Carlos-0798/desk-buddy/hub/README-zh-CN.txt

Desk Buddy Hub 1.7.1 — R9 / 离线配置恢复

运行项目根目录 outputs/hub-r9/windows-final/DeskBuddy.Hub.exe；不需要更新设备固件。
这次修复的是 Hub 未连接启动时显示默认外观的问题，不是设备保存丢失。
首次使用新版先连接一次；以后关闭重开，未连接时显示上次设备回读的主题、角色和按键配置。
合法的未发送本地草稿也会自动保留；页首明确区分“本地草稿”“上次设备快照”“设备当前回读配置”。
第一次没有历史记录时显示“示例配置”，不把默认图当成设备当前状态。
重新连接只读取，设备回读优先。保留的草稿可按“载入保留的本地草稿”放回编辑器，再自行选择预览或保存。
载入草稿不会发送配置、开启输出或连接设备；明确按“读取设备”会用设备值替换并清除保留草稿。
本地快照不代表设备闪存保存成功，设备“预览/保存”原有 ACK/GET/STATUS 规则不变。
缓存位置：%LOCALAPPDATA%\DeskBuddy\Hub\workspace-v1.json，含独立快照/草稿、校验和及 .bak 恢复副本。
不缓存设备 ID、蓝牙配对、连接权限、实时状态或输出开关；不可用缓存会提示，保存失败可导出 JSON。
本轮不改变屏幕休息设置的独立设备保存，也不新增语言、缩放或连接自动恢复。
构建：hub/build.ps1 -Publish -OutputDirectory outputs/hub-r9/windows-final，拒绝覆盖非空目录。
软件证据见 outputs/hub-r9；测试只用隔离文件和模拟连接，不接触真实 AppData 或设备。
以下保留历史版本说明。
Desk Buddy Hub 1.7.0 — R8 / R3H 自定义休屏时间

运行项目根目录 outputs/hub-r8/windows-final/DeskBuddy.Hub.exe。
设备页“屏幕休息”支持 USB／电池各自选择：永不、30秒、1分钟、5分钟、20分钟、30分钟、1小时、自定义。
自定义填 1–720 的整数分钟，7分钟保存为420秒；无小数、负数、四舍五入或自动截断。
旧固件没有 display_custom 能力时保留原四档，长时间和自定义需升级设备固件。
连接只读取，不改变已有五分钟设置。未保存输入保留到同一连接内的切页或界面语言切换；轮询不覆盖文字、光标或选择。
读取当前会明确换回设备值；保存失败保留输入，等新鲜状态后可手动重试，不自动重发。
保存经 ACK/GET/STATUS 验证，与按键/外观草稿、224字节bank及输出开关独立，不发送隐藏OUTPUT1。
背光控制仍由 backlight_control 实时报出，休屏与整机关机不同。
构建：hub/build.ps1 -Publish -OutputDirectory outputs/hub-r8/windows-final；拒绝覆盖非空目录。
软件证据见 outputs/hub-r8，实板与物理验收由独立记录说明；本说明不把离线软件测试当作实物验收。
若需降级R3G，应先把两路时长恢复为永不、30秒、1分钟或5分钟，避免旧固件无法解码扩展时长记录。
以下为历史版本说明。

Desk Buddy Hub 1.6.0 — R7 / R3G 屏幕休息

当前构建入口：../outputs/hub-r7/windows-final/DeskBuddy.Hub.exe。
“设备”页新增独立屏幕休息卡：USB/电池各选永不、30秒、1分钟或5分钟；读取、保存、立即休屏、唤醒。
读取实时状态，保存经独立 DISPLAY SET/GET/STATUS 核对，不改变按键/外观草稿或224字节配置库。
初始固件未接 LITE 时只隐藏画面，背光仍亮；只有明确 backlight_control=1 才显示背光可控。
休屏不是整机关机，也未据此宣称续航提升。首次实体输入只唤醒，抬起后再操作；输出开关不自动开启。
HID 暂停包括屏幕休息、唤醒输入隔离和测试页；它不等于用户关闭输出。
动作选择增至40项：新增本地“立即休屏”，旧设备缺少sleep_binding能力时阻止发送，原映射保持兼容。
连接和轮询只读取，不自动保存默认超时、不重放本地草稿、不唤醒休屏。
当前软件证据与硬件验收分别记录在 outputs/hub-r7；本说明不把离线测试当作补线/背光实物验收。
默认构建目录已切换R7，仍拒绝覆盖非空目录；明确发布命令为 hub/build.ps1 -Publish -OutputDirectory outputs/hub-r7/windows-final。
协议见 PROTOCOL.md，Core API 见 DeskBuddy.Core/API.md。以下保留旧版历史说明，新差异以上述协议为准。

Desk Buddy Hub 1.5.1 — R6.1 / R3F 页面兼容候选（历史）

本轮新增 preserve_page_output 能力与 hid_suppressed 状态；输出开关开启和测试页暂停发送分别显示。
新能力设备的诊断/活动页保留开关，暂时暂停 HID；信息/管理/语言/工具页允许普通输入。
校准仍关闭输出；返回不自动发送开启命令。旧 R3E 没有新能力时保持旧页面规则。
构建默认输出 outputs/hub-r6-1，仍拒绝覆盖非空发布目录；旧 R6 文件不变。
本轮 managed Core 与 App 构建结果见 ../outputs/hub-r6-1/core 与 build 日志。
当前候选未因这些检查而宣称 GUI、实板或物理验收通过；等待根代理整合验证。
协议与 API 见 PROTOCOL.md / DeskBuddy.Core/API.md。

以下为 R6 已验证基线与 R5 历史说明；R3F 差异以上述及能力协商文档为准。

Desk Buddy Hub 1.5.0 — Windows 伴生控制软件（R6 / 固件 R3E）

当前版本：2026-10-05 R6
运行 ../outputs/hub-r6/windows/DeskBuddy.Hub.exe。
使用说明及手动观察步骤：../outputs/hub-r6/START-HERE-zh-CN.txt。
修复外观/动作/配置操作不必要关闭输出；按键、旋钮、触摸联动角色；统一圆角下拉框，保留键盘语义与滚动。
476项WPF检查、1965项Core断言、182项USB/BLE实板协议检查通过；正式EXE的USB窗口连接、输出ON下预览/保存/开心、再OFF与复读通过。实屏动画观感和此版本纯电池尚待用户观察。
build.ps1 发布默认目录更新为 outputs/hub-r6，非空目录仍拒绝覆盖；旧R5交付保留。
完整证据、限制、哈希见 ../outputs/hub-r6/release-status.json。

以下为 R5 历史说明；与上述 R6 行为冲突时以上述和 PROTOCOL.md 的能力协商规则为准。

当前验收状态（2026-10-05）
R5 正式电脑端的普通启动、离线渲染、Core 检查及正式 EXE 的 USB 实板 smoke 均已通过。
R3D4 实板自动检查通过：USB 静默、10 次 BLE 加密重连、28 项 BLE 检查，以及两轮各 32 项保存与软件重启检查。
保存检查包含 CCCD 退订后立即请求软件重启；原保存配置、触摸校准、语言和 BLE 配对已恢复并完成保持性复验。
正式 GUI 的 BLE 连接、状态更新和走路试播回读已通过；后续 GUI 还原、撤权提示、断开与重连尚未完成，不能称完整 GUI 验收通过。
R3D4 保留 R3D3 的受控软件重启存储屏障：排在既有后台保存之后执行，取得 FS 锁、刷新缓存并保持锁直至复位。
R3D4 另在等待重启或重启失败时继续重试原连接的 HID 零报告释放，不发送新按下报告、不重新挂接 USB 或重启蓝牙广播。
R3D4 目标构建及静态检查已通过；新增 C++ 测试仅编译，runtime 断言执行数为 0，不替代异常释放路径的实物验证或整机验收。
这不等于已解决物理断电、实体 Reset 或 DFU 中断写页的所有风险；物理冷启动与电池独立运行仍须另行验收。
最终 EXE 哈希、检查数量和最新结论见 ../outputs/hub-r5/release-status.json
及 ../outputs/hub-r5/TEST-REPORT-zh-CN.txt；不要用历史版本记录代替最终复验。

下一步：可以开始五项人工验收
1. 电池独立供电下的 BLE 管理。
2. 实屏动作与触摸。
3. BLE 管理与真实 HID 输入并用。
4. Windows 睡眠后恢复。
5. 正常保存后的完全断电与设置保持。
具体操作与停止条件见 ../outputs/hub-r5/MANUAL-CHECKLIST-zh-CN.txt。
五项均未因自动检查通过而视为完成；软件 REBOOT 不能代替同时断开 USB 与电池后的物理冷启动。

定位
本软件管理 Desk Buddy 原型机，可选择 USB CDC 串口或已配对设备的 BLE GATT 管理连接。
R5 支持通过 BLE 读取状态、编辑/预览/保存三套配置与按键/外观、动作试播及还原。
管理连接与 USB/BLE 媒体键/键盘 HID 输出是两个独立选择，连接 Hub 不会自动开启 HID。
电池供电时，已建立的 BLE 管理连接可以在拔掉 USB 后继续使用；仅 USB 管理会随拔线断开。
本软件不需要账号、云服务、管理员权限或开机自启。

启动
1. 解压完整 Windows 发布包到普通本地文件夹。
2. 双击 DeskBuddy.Hub.exe。首次启动不会自动开启设备输出。
3. 管理连接选择“USB 线缆”，重新检测并选择 Desk Buddy 的 COM 端口后连接。
4. 如果出现端口占用，关闭 Arduino 串口监视器或其它测试程序，再重试。
5. 若看到旧版 R2C，基本状态仍可读；配置编辑需要 R3，新增主题/角色/主页模式需要 R3A。
   Hub 不自动刷写固件。不要用其它型号的固件或擦除校准/配对数据。
用户已确认本机双击能打开 Hub；签名暂不处理，不影响正常本地开发与交付。
R3D4 自动检查已通过；人工五项及尚未完成的 GUI 还原/撤权提示/断开重连仍需验证，进度以本轮测试报告为准。

BLE 管理连接
1. 先确认 Desk Buddy 已在 Windows 蓝牙设置中配对；已有配对无需删除重建。
2. 在小屏“菜单 → 设备信息 → 蓝牙管理 → 允许蓝牙连接”打开最长 60 秒连接窗口；
   或在 USB 管理中点“通过 USB 允许 BLE”。这一步会关闭 HID 输出。
3. 断开当前 USB 管理（可保留 USB 供电），管理连接选“蓝牙 LE · 已配对设备”，
   重新检测、选择自己的 Desk Buddy，再连接。成功后显示 BLE GATT 管理。
4. 连接采用加密链路、已绑定设备与设备端管理授权；配对本身不等于管理授权。
5. 开始管理后连续 15 秒没有成功请求会撤权。正常 Hub 轮询保持会话；
   断开、睡眠或异常后重新在设备端授权，再手动重连，不重放旧操作。
这些是 R5 的使用流程；最终硬件能否正常执行仍以本轮发布状态和测试报告为准。

页面
设备：管理连接、USB/BLE HID 通道、输出开关、电量估算、当前配置和输入状态。
控制配置：K1–K6、顺转、逆转、旋钮按压、三个触屏键，共 12 个映射。
外观：八种主题、十二个角色、三种主页模式、待机动画开关、强调色及软件预览。
诊断：输入计数、固件与连接信息、有限长度的日志和导出。

配置的三个阶段
编辑只改变电脑上的草稿。
预览把草稿应用到设备内存，不写入 Flash；设备输出会关闭。
保存才把完整配置写入设备，并读取确认；设备输出也会关闭。
预览/保存会提交全部三套配置，并把当前正在编辑的页签设为设备活动配置。
还原恢复设备最后保存的配置。未保存预览在设备断电/重启后丢失。
发生版本冲突时先重新读取设备；Hub 不会在重连时偷偷覆盖设备。
MEDIA / STUDY / WORK 是三套独立保存的配置，不是会自动识别应用的智能模式。
出厂按键映射完全相同；切换名称本身不会自动改变用途。
MEDIA：建议配置播放、切歌、音量；STUDY：建议配置学习常用快捷键；WORK：建议配置工作软件快捷键。
这些只是使用建议，快捷键须由你在“控制配置”页设置；每套外观也可以不同。
它们与“表情面板 / 桌面伙伴 / 电子宠物”这三个显示模式是两回事。
当前配置名称使用 1–15 个 ASCII 字符；Hub 和屏幕界面可以使用中文或英文。
中文界面不受此限制；板载配置名称本身暂不支持中文。
导入/导出的是整个三配置集合；不包含触摸校准、蓝牙配对信息或任何执行脚本。

新增外观与桌宠
表情面板：全部十二个角色使用专用大头像，显示待机、眨眼和开心表情。
桌面伙伴：在设备小屏显示完整身体、脚/尾巴和待机动作。
电子宠物：显示完整伙伴与本次开机互动次数，并对本机操作短暂作出反应。
三种模式都保留连接状态、电量、菜单与三个触屏控制按钮。
主题、角色和模式可以独立组合，共 288 种；各套 MEDIA / STUDY / WORK 可以不同。
新的海洋、落日、花园、蓝图主题带有各自背景细节；兔子、幽灵、团子、太空伙伴、
狐狸、熊猫等采用有明暗、服饰和轮廓细节的原创像素游戏角色素材。
完整角色含待机、眨眼、开心、两帧迈步；幽灵以尾部摆动对应迈步。
旋钮格数触发短暂迈步，按钮/旋钮按下或有效触摸触发开心反馈。
互动统计来自按钮稳定按下、旋钮格数/按下、校准以外的有效触摸；松开不重复计数，
Hub命令不算互动。次数跨配置保留，但重启或重置计数后归零，不写入Flash。
R3B中，轻点主页中央角色区域会回应开心和爱心，不发送媒体键或其它HID。
30秒无有效实物输入后闭眼显示Zzz；下一次输入唤醒，原有绑定仍照常执行。
打盹只是视觉状态，不是MCU省电，也不自动关闭输出。
关闭动画会停止眨眼/迈步/爱心浮动循环，仍保留静态开心、爱心、打盹和互动计数。
R5外观页的“动作预览”把动作作为连续6秒演示：待机、眨眼、开心、走路、打招呼、休息、醒来。
不再让用户选择单独的“走路A / B”帧。全身模式自动交替两帧并轻微移动，头像模式不提供走路。
动作区旁边直接显示动画。未连接设备时只在电脑预览；连接支持该功能的R3C后可同步小屏。
同步试播会先把当前草稿临时应用到设备，并关闭输出，再播放动作；不会保存到Flash。
“预览到设备”也会播放当前选择的动作。满意后再保存配置；动作演示本身不保存。
点击“停止预览”或等待6秒会回到真实设备状态，不会自动重新开启输出。
明确点击动作时临时播放动画，即使“日常动画”关闭；不会改变该开关的保存值。
设备的按键/旋钮/有效触摸会结束试播；原有绑定仍按当时输出状态执行。
演示不是物理输入，不增加设备真实互动计数，不发送媒体键。
设备30秒无输入时的打盹仍是正常行为；临时“唤醒”演示结束后可能回到打盹。
设备声明 BLE 管理和动作试播能力后，USB 或 BLE 管理均可向小屏试播；仅 HID 配对不具备此管理能力。
本轮桌宠在设备屏幕上，不是 Windows 桌面悬浮窗；没有喂养、经验值或成长存档。
Hub与设备共用64×60全身角色、48×30专用头像及RGB565色板；Hub外框/文字仍是软件预览。
实际完整固件渲染图见配套 preview/index.html，不能当作实物显示照片。

旧固件兼容
旧 R3 的 HELLO 没有新能力字段，Hub按4主题、4角色、仅表情面板处理。
离线可编辑所有新外观，连接旧固件时不支持的配置会在发送前被拒绝；不会偷偷改回旧ID。
所有三套配置都会检查，不能只确保当前显示的一套兼容。
R3A支持相同288种配置，但新头像、轻触和打盹需要R3B。
R3C通过HELLO明确声明animation_preview能力，才允许新的远程动作试播。
BLE管理要求设备明确声明ble_management能力及专用GATT服务；旧R3C及更早固件仍使用USB管理。
旧R3B仍可编辑兼容配置，但动作仅电脑预览；Hub会明确提示，不会假装小屏已播放。
预览不会自动升级固件。
升级 R3B 后旧配置ID保持原样，表情模式换成新头像；若以后降级到 R3，须先保存旧版兼容的三套配置，
例如导入 01-original-face.json 再保存，以免旧固件拒绝新样式/模式。

按键能力
支持播放暂停、上一曲、下一曲、静音、音量加减；
支持一个标准键盘键加 Ctrl/Shift/Alt/GUI 修饰键的一次按下/松开；
左/右修饰键独立保留；GUI 在 Windows 上对应 Win 键。
支持打开菜单、记录标记、关闭输出、切换下一配置等设备本地动作。
不包含多步宏、长按保持或任意运行电脑程序的能力。
触屏按键的标签随映射调整，不应把已重映射的按钮当作原有媒体键。
主板 USER SW 长按约两秒关闭输出，独立于自定义映射。

连接和恢复
USB/BLE 管理连接负责 Hub 读写设置；USB/BLE HID 通道负责设备操作电脑，分别选择。
切换通道或修改配置后，请确认映射再主动开启输出。
关闭 Hub 不等于停止设备独立工作；要停止操作电脑，先关闭设备输出。
Windows 休眠、拔线或端口异常后，界面必须先恢复新鲜状态再允许操作。
不要同时运行两个 Hub 实例争用同一串口。
BLE 正常断开会请求并核对管理撤权，不改变原 HID 输出状态；退出 Hub 不等于关闭媒体输出。
若撤权/退订未获确认，软件会报告失败；在设备端撤销或停止管理请求并等待空闲超时。
另一管理端正在修改设备时可能返回 BUSY；不要反复发送写入。配置版本冲突返回 STALE，先重新读回。
显示未知或过期状态时，先检查连接，不应将旧数字当作当前测量。

电池显示的边界
百分比是根据电压作出的粗略估计，不是电量计芯片测得的真实剩余容量。
USB 供电状态不能证明正在充电，Hub 也不能测量电池温度、充电电流或实际续航。

本版不含
前台应用自动配置切换、云同步、任意图片/GIF皮肤上传、手机 App、无线固件升级或自动固件升级。
这些限制不影响设备离线执行已保存的媒体键/热键配置。

开发
源代码：DeskBuddy.Core（协议/配置/文件/有界BLE分片），DeskBuddy.App（WPF/USB串口/Windows BLE GATT/界面）。
协议定义见 PROTOCOL.md；固件位于 ../firmware/DeskController。
Windows x64 + .NET 10 SDK 可构建；发布包自带运行时，最终用户无需单独安装 SDK。
Core.Tests 为主机测试，不冒充实物按压、显示外观或电池断电验收。
具体本轮自动测试结果和待人工项目见发布目录 TEST-REPORT 与 MANUAL-CHECKLIST。
项目根目录执行 hub/build.ps1 -Publish，默认输出 outputs/hub-r5/windows；不自动启动应用。
可选签名工具独立于本地发布，说明在 outputs/hub-r5/signing；当前没有宣称可信签名发布。

调试与本地演示
在已打开的命令行中运行 DeskBuddy.Hub.exe --demo 可进入明确标注的演示模式，
它不访问实物串口或蓝牙。正常使用请直接双击 EXE，不加 --demo。
--render-smoke <输出目录> 只做离线测试；--device-smoke 会访问实物，仅供测试使用。
