Carlos-0798/desk-buddy/hub/DeskBuddy.App/README-zh-CN.txt

Desk Buddy Hub 1.7.1 — R9 / 离线配置恢复

运行项目根目录 outputs/hub-r9/windows-final/DeskBuddy.Hub.exe；不需要更新设备固件。
这次修复的是 Hub 未连接启动时显示默认外观的问题，不是设备保存丢失。
首次使用新版先连接一次；以后关闭重开，未连接时显示上次设备回读的主题、角色和按键配置。
合法的未发送本地草稿也会自动保留；页首明确区分“本地草稿”“上次设备快照”“设备当前回读配置”。
第一次没有历史记录时显示“示例配置”，不把默认图当成设备当前状态。
重新连接只读取，设备回读优先。保留的草稿可按“载入保留的本地草稿”放回编辑器，再自行选择预览或保存。
载入草稿不会发送配置、开启输出或连接设备；明确按“读取设备”会用设备值替换并清除保留草稿。
本地快照不代表设备闪存保存成功，设备“预览/保存”原有 ACK/GET/STATUS 规则不变。
缓存位置：%LOCALAPPDATA%\DeskBuddy\Hub\workspace-v1.json，含独立快照/草稿、校验和及 .bak 恢复副本。
不缓存设备 ID、蓝牙配对、连接权限、实时状态或输出开关；不可用缓存会提示，保存失败可导出 JSON。
本轮不改变屏幕休息设置的独立设备保存，也不新增语言、缩放或连接自动恢复。
构建：hub/build.ps1 -Publish -OutputDirectory outputs/hub-r9/windows-final，拒绝覆盖非空目录。
软件证据见 outputs/hub-r9；测试只用隔离文件和模拟连接，不接触真实 AppData 或设备。
以下保留历史版本说明。
Desk Buddy Hub 1.7.0 — R8 / R3H 自定义休屏时间

运行项目根目录 outputs/hub-r8/windows-final/DeskBuddy.Hub.exe。
设备页“屏幕休息”支持 USB／电池各自选择：永不、30秒、1分钟、5分钟、20分钟、30分钟、1小时、自定义。
自定义填 1–720 的整数分钟，7分钟保存为420秒；无小数、负数、四舍五入或自动截断。
旧固件没有 display_custom 能力时保留原四档，长时间和自定义需升级设备固件。
连接只读取，不改变已有五分钟设置。未保存输入保留到同一连接内的切页或界面语言切换；轮询不覆盖文字、光标或选择。
读取当前会明确换回设备值；保存失败保留输入，等新鲜状态后可手动重试，不自动重发。
保存经 ACK/GET/STATUS 验证，与按键/外观草稿、224字节bank及输出开关独立，不发送隐藏OUTPUT1。
背光控制仍由 backlight_control 实时报出，休屏与整机关机不同。
构建：hub/build.ps1 -Publish -OutputDirectory outputs/hub-r8/windows-final；拒绝覆盖非空目录。
软件证据见 outputs/hub-r8，实板与物理验收由独立记录说明；本说明不把离线软件测试当作实物验收。
若需降级R3G，应先把两路时长恢复为永不、30秒、1分钟或5分钟，避免旧固件无法解码扩展时长记录。
以下为历史版本说明。

Desk Buddy Hub 1.6.0 · R7 / R3G 屏幕休息

运行项目根目录 outputs/hub-r7/windows-final/DeskBuddy.Hub.exe。
设备页新增独立屏幕休息设置；USB/电池分别支持永不、30秒、1分钟、5分钟。
保存屏幕设置与三套按键/外观草稿完全分开；连接仅读取，休屏和唤醒都不会自动开启输出。
初始 backlight_control=0 仅黑画面、背光仍亮；后续补 LITE 线与匹配固件后，能力1才表示背光可控。
输出OFF与HID暂停分别显示；暂停也可能来自睡眠或唤醒隔离，不能一概当作诊断页。
首次实体输入只唤醒，等待松开与隔离结束再操作；Hub状态轮询不会唤醒。
40项动作选择新增“立即休屏”；旧固件无sleep_binding时本地拒绝该新绑定，已有映射与格式不变。
新软件检查/发布证据在 outputs/hub-r7，实际补线/背光/输入验收由实物记录单独说明。
以下为历史版本记录；不代表R7实物已验收。

Desk Buddy Hub 1.5.1 · R6.1 / R3F 页面兼容候选（历史）

新增严格可选 preserve_page_output 能力；旧固件仍使用既有页面校验。
输出状态额外显示 HID 暂停发送，保持开关 ON 不等于测试页正在发送输入。
诊断/活动暂时抑制，校准仍 OFF；信息/管理/语言/工具允许正常输入与显式开启。
没有自动 OUTPUT 1、没有导航后恢复旧 ON、没有命令重放。
新 managed 检查和构建输出位于 outputs/hub-r6-1；当前 GUI 与实板复验由根代理单独执行。
以下 R5 验收记录仅为历史基线，不代表当前候选已验收。现协议见 ../PROTOCOL.md。

Desk Buddy Hub 1.4.0 · R5 Windows 原生 WPF 程序

当前状态（2026-10-05）
R5 正式电脑端的普通启动、离线渲染、Core 检查及正式 EXE 的 USB 实板 smoke 均已通过。
R3D4 实板自动检查通过：USB 静默、10 次 BLE 加密重连、28 项 BLE 检查，以及两轮各 32 项保存与软件重启检查。
其中包括 CCCD 退订后立即请求软件重启；原保存配置、触摸校准、语言和 BLE 配对已恢复并完成保持性复验。
正式 GUI 的 BLE 连接、状态更新和走路试播回读已通过；GUI 还原、撤权提示、断开与重连尚未完成，不能称完整 GUI 验收通过。
R3D4 保留受控软件重启存储屏障：先排在既有后台保存之后，取得 FS 锁并刷新缓存，保持锁直到复位。
等待重启或重启失败时仅继续重试原连接的 HID 零报告释放，不发送新按下报告、不重新挂接 USB 或重启蓝牙广播。
R3D4 目标构建及静态检查已通过；新增 C++ 测试仅编译，runtime 断言执行数为 0，不能据此宣称异常释放路径或整机全部通过。
这项存储屏障不等于物理冷启动、断电/实体 Reset/DFU 中断写页风险已经验收。
最终 EXE 哈希、检查数量与最新结论以项目根目录 outputs/hub-r5/release-status.json
及 outputs/hub-r5/TEST-REPORT-zh-CN.txt 为准。用户确认本机双击可打开 Hub，签名暂不处理。
用户入口与人工检查：outputs/hub-r5/START-HERE-zh-CN.txt、outputs/hub-r5/MANUAL-CHECKLIST-zh-CN.txt。
接下来可以开始五项人工验收：电池独立供电 BLE 管理、实屏动作与触摸、BLE 管理与真实 HID 并用、
Windows 睡眠后恢复、正常保存后的完全断电与设置保持。五项均仍待人工确认；软件 REBOOT 不等于物理冷启动。

连接与权限
设备页可选择 USB CDC 管理，或 Windows 已配对设备的 BLE GATT 管理。
USB：插数据线，选“USB 线缆”，重新检测端口后连接。
BLE：小屏“菜单 → 设备信息 → 蓝牙管理 → 允许蓝牙连接”，或先由 USB 管理允许 BLE；
随后断开原管理连接，选“蓝牙 LE · 已配对设备”，重新检测并选择自己的 Desk Buddy。
已有配对无需删除重建；Hub 不自动配对或升级固件。
管理连接成功后读取状态与配置，不自动保存电脑草稿，也不自动开启设备输出。
BLE 管理要求专用服务、能力声明、加密绑定及设备授权，初次连接窗口最长 60 秒；
成功开始管理后，连续 15 秒无成功请求自动撤权，正常轮询保持会话。
正常断开会核对撤权并退订；失败会提示，必要时设备端撤权或等待超时。重新连接不重放旧写入。
管理 USB/BLE 与 HID 输出 USB/BLE 分别选择。退出 Hub 不等于停止独立运行的 HID；要停止操作电脑先关闭输出。

设置与外观
控制配置含六键、旋钮双向/按压、三个触屏键，共 12 个映射。
MEDIA / STUDY / WORK 是三套独立配置的用途标签，默认映射相同，不自动识别电脑应用。
编辑仅改变电脑草稿；“预览到设备”临时应用 RAM；“保存到设备”才持久化并回读确认。
预览/保存提交全部三套配置并激活正在编辑的一套，都会关闭 HID 输出。
“还原”返回设备最近保存值；导入/导出不包含触摸校准或蓝牙配对。
三种显示模式、八种主题和十二个角色可独立组合，共 288 种。
表情面板使用专用 48×30 头像；桌面伙伴使用 64×60 全身图；电子宠物额外显示本次开机互动统计。
Hub 内嵌与设备同源的生产图片，采用 nearest-neighbor 绘制；电脑界面是软件预览，不是实屏照片。

连续动作预览
动作卡在控件旁直接显示动画：待机、眨眼、开心、走路、打招呼、休息、醒来。
每次连续约 6 秒，可随时停止；不再使用独立“走路 A/B”单帧按钮。
全身模式可以走路，头像模式禁用走路并提示切换模式。
离线只在电脑演示；连接声明动作能力的设备后，可选择电脑与设备同步试播。
USB 或 BLE 管理均可试播：先临时应用当前草稿，再播放动作，输出 OFF，不执行 SAVE。
“预览到设备”也播放当前选定动作；“保存到设备”只保存设置，不保存临时演示状态。
显式试播会临时覆盖关闭的日常动画开关，但不修改保存值。停止或到期回到真实状态，不自动恢复 ON。
试播不是物理输入，不增加真实互动计数或产生 HID；真实输入可以结束试播，原映射按当时门控执行。

设备日常行为与兼容
30 秒无有效实物输入后闭眼显示 Zzz；下次实物输入唤醒，绑定仍按输出状态执行。
打盹是视觉状态，不代表 MCU 省电，也不自动关闭输出。角色区轻触只给本地反馈，不发 HID。
互动计数在 RAM，重启清零；没有喂养、成长存档或 Windows 悬浮桌宠。
旧 R3 缺少新能力字段时按 4 主题/4 角色/表情模式处理，写入前检查三套配置。
R3A 的新样式、R3B 的专用头像/互动、R3C 的远程动作与 R3D 系列的 BLE 管理分别按能力处理。
旧固件仍可使用其支持的 USB 管理功能，不会假装完成无线管理或自动升级。
电池读数是电压估算，不是充电状态、温度或续航验收。

构建与离线验证（项目根目录）
  tools/dotnet/dotnet.exe build hub/DeskBuddy.App/DeskBuddy.App.csproj -c Release
  hub/build.ps1 -Publish
正常本地发布默认 outputs/hub-r5/windows，自包含 win-x64 单文件，不自动启动。
已有发布目录不会自动删除或覆盖；可显式提供 R5 下新的空 OutputDirectory。
构建需要 assets/companions/r2/compiled 的 60 张全身 PNG 和 manifest，
以及 r3/compiled 的 36 张头像 PNG 和 manifest；不能只复制 App 文件夹而遗漏素材和 Core。
可选签名准备使用 build.ps1 -ForSigning；并非本地开发/运行的前置条件。
--demo 使用模拟设备，--render-smoke <目录> 做离线交互与截图检查，两者不访问 COM/蓝牙。
实物测试由主任务单独执行；不要将主机测试、构建通过或历史版本通过升级成最终硬件验收。
