Carlos-0798/desk-buddy/assets/bench-prototype.jpg

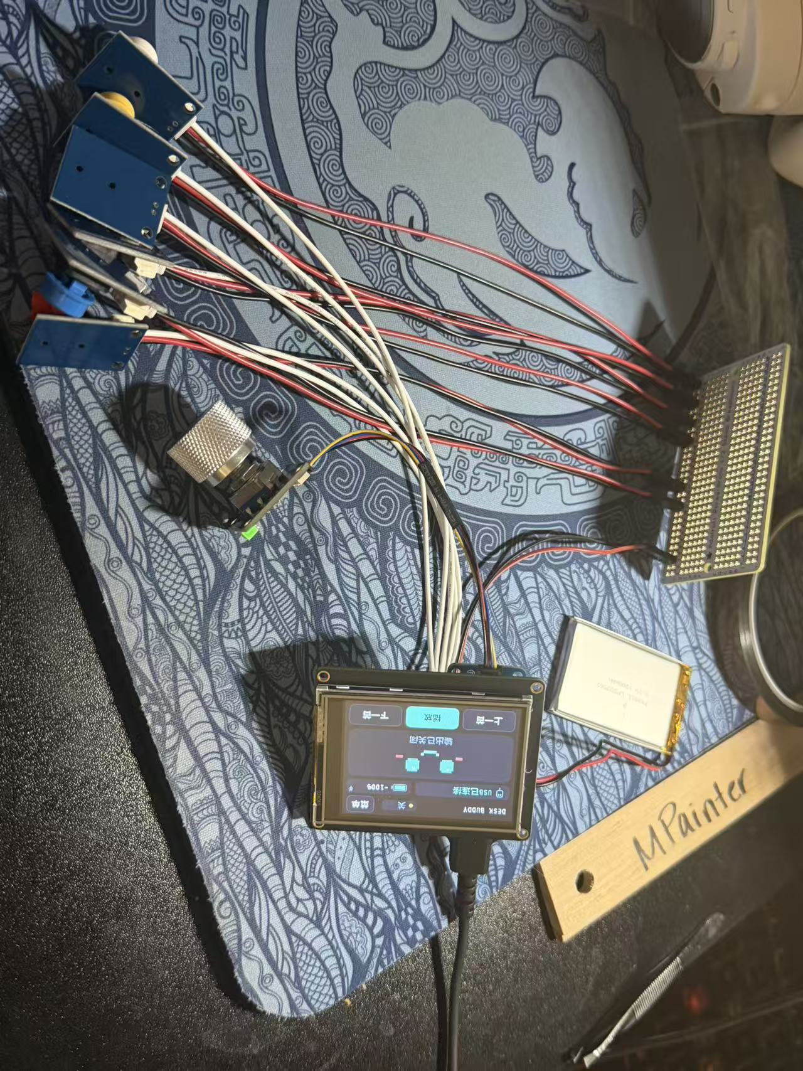
assets/bench-prototype.jpg
