Carlos-0798/desk-buddy/assets/companions/r2/fantasy-walk-original.png

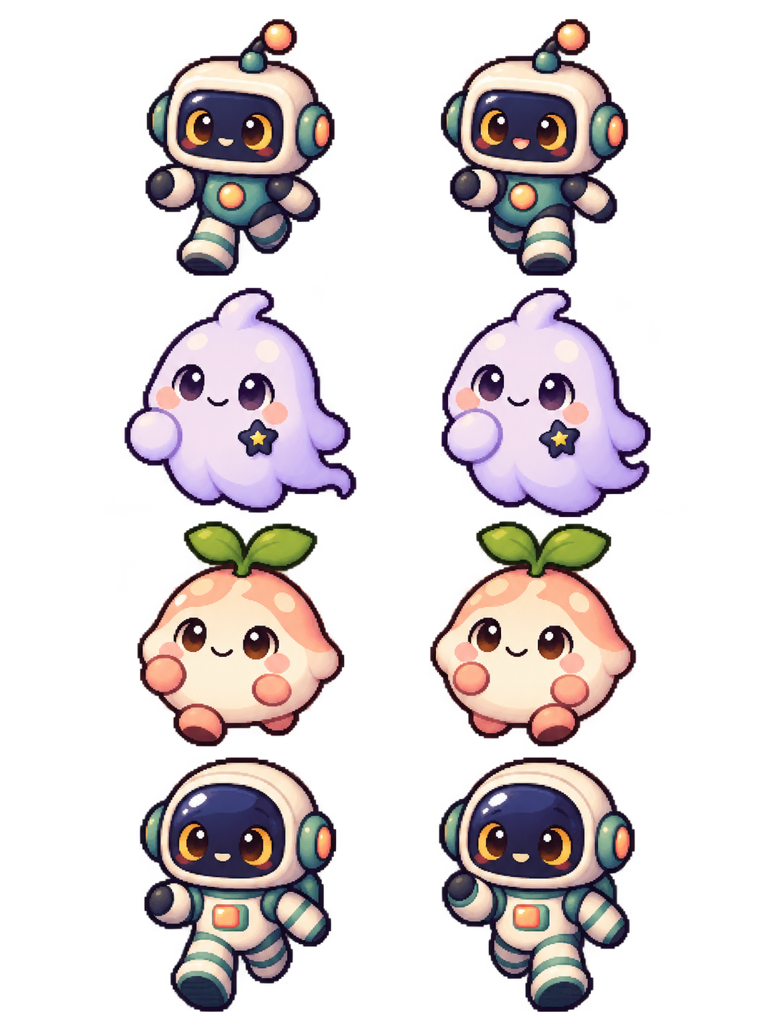
assets/companions/r2/fantasy-walk-original.png
