Carlos-0798/desk-buddy/assets/companions/r2/woodland-atlas-original.png

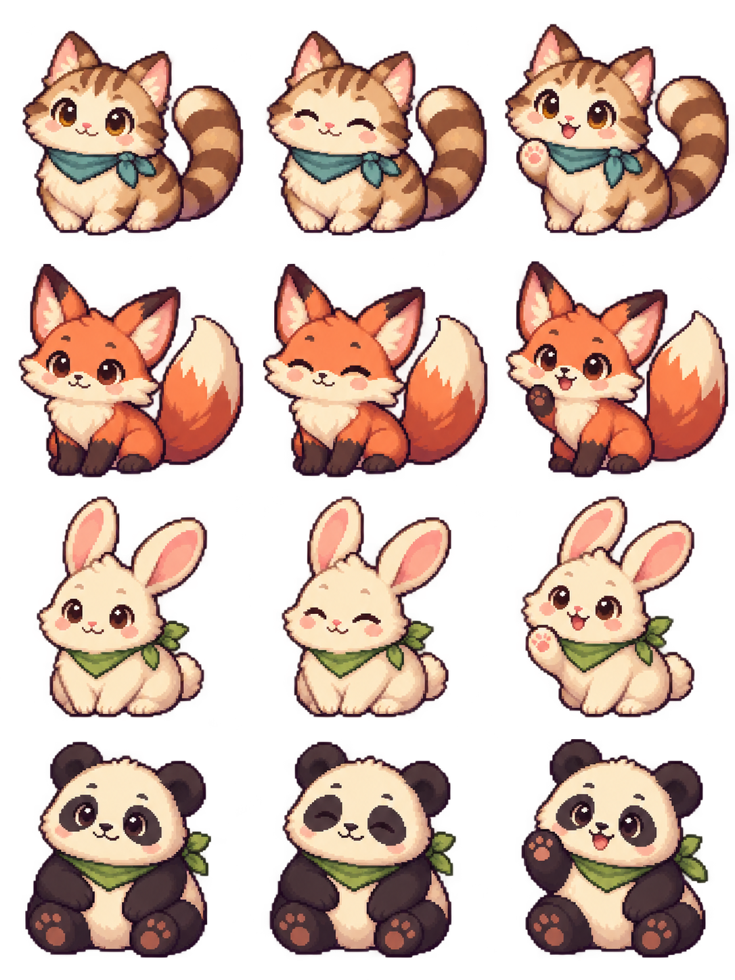
assets/companions/r2/woodland-atlas-original.png
