Carlos-0798/desk-buddy/assets/companions/r2/woodland-walk-v2-original.png

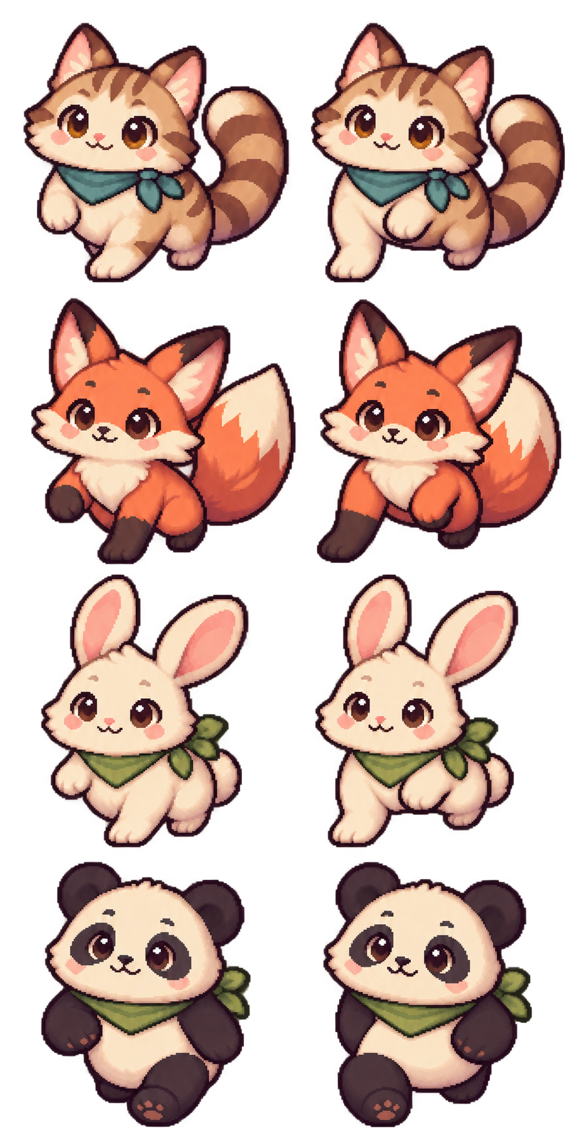
assets/companions/r2/woodland-walk-v2-original.png
