Carlos-0798/desk-buddy/assets/companions/r3/classic-portraits-v2-original.png

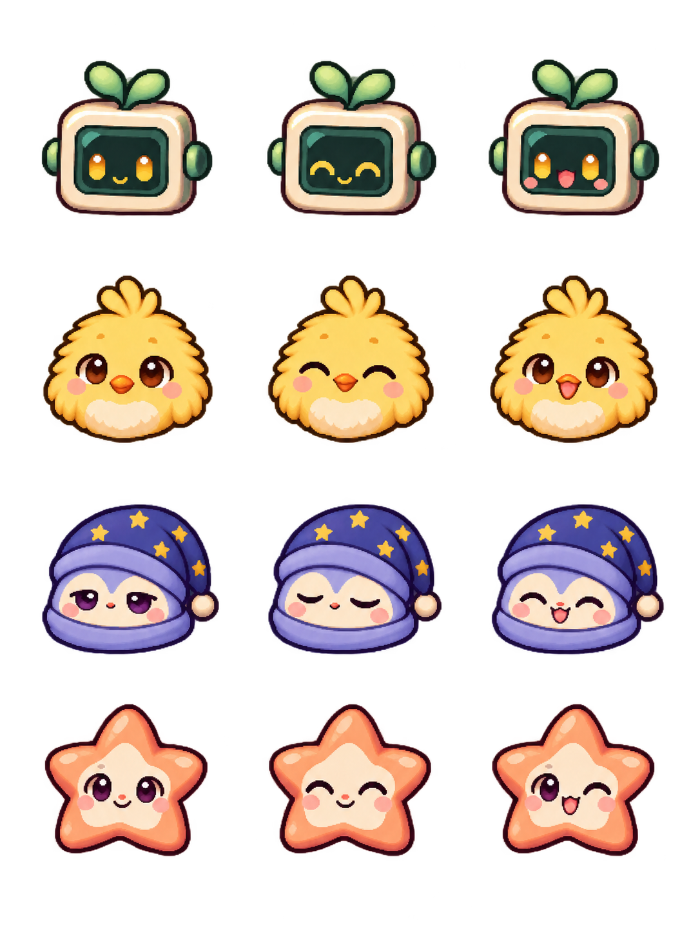
assets/companions/r3/classic-portraits-v2-original.png
