Carlos-0798/desk-buddy/assets/companions/r3/fantasy-portraits-original.png

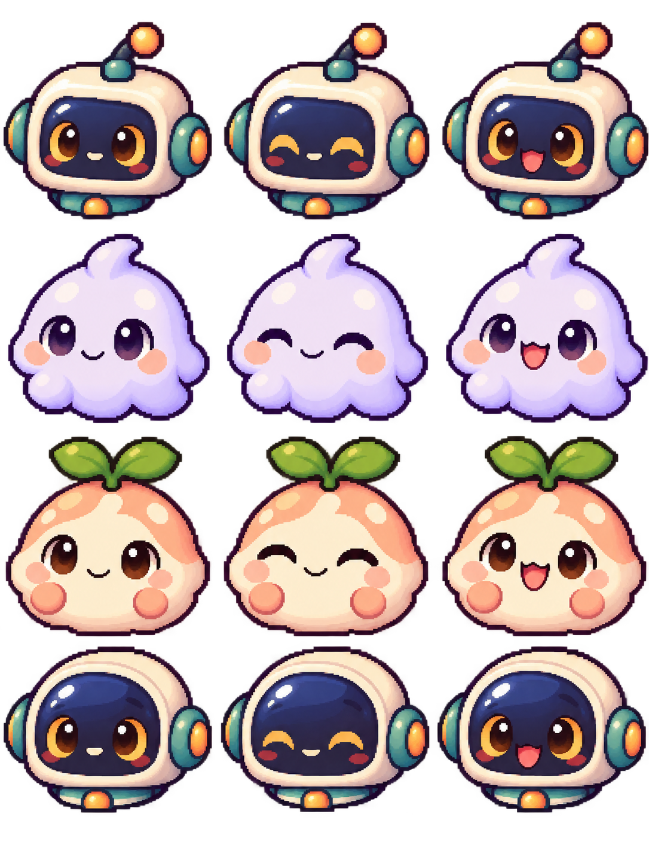
assets/companions/r3/fantasy-portraits-original.png
