Carlos-0798/desk-buddy/assets/companions/r3/woodland-portraits-original.png

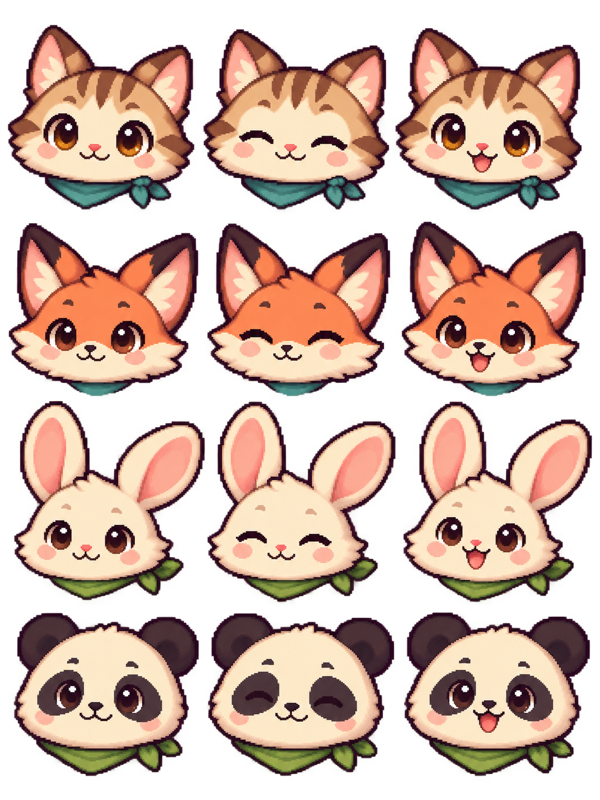
assets/companions/r3/woodland-portraits-original.png
