Carlos-0798/desk-buddy/assets/enclosure-exploded.png

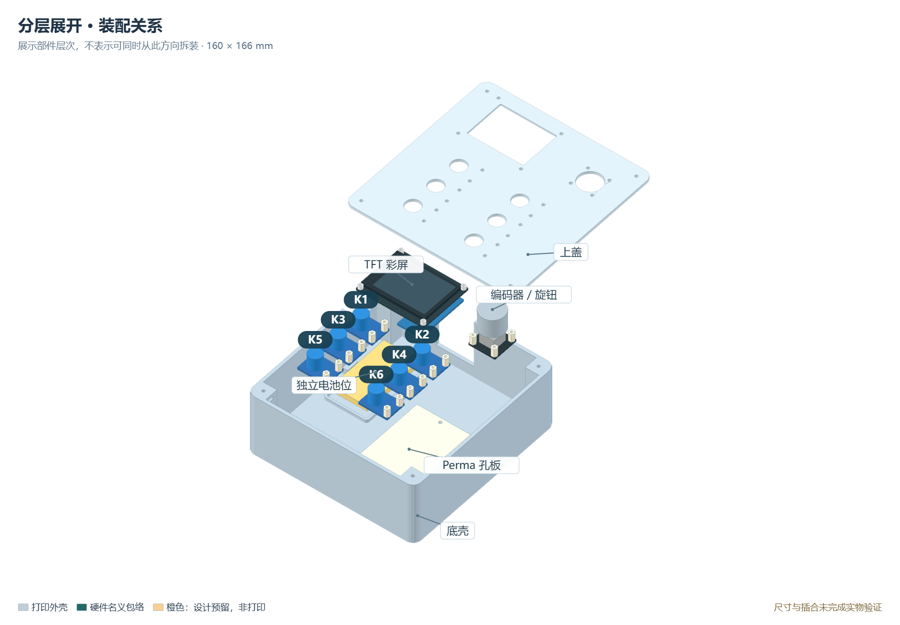
assets/enclosure-exploded.png
