Carlos-0798/desk-buddy/assets/enclosure-routing.png

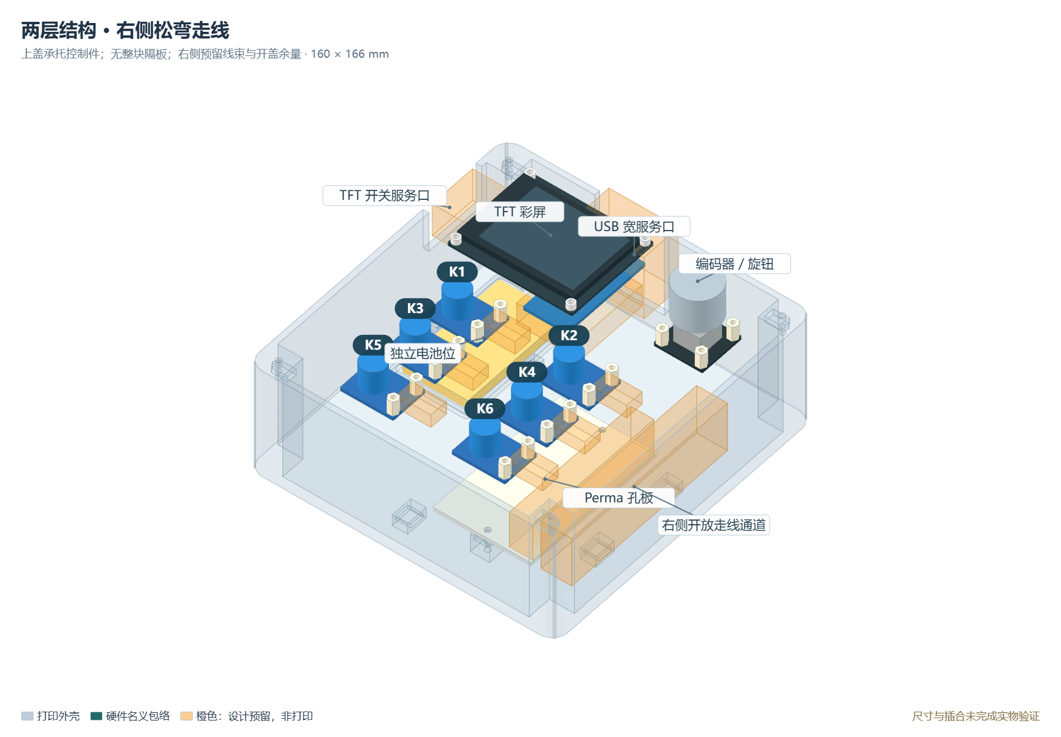
assets/enclosure-routing.png
