Carlos-0798/desk-buddy/assets/hub-appearance.png

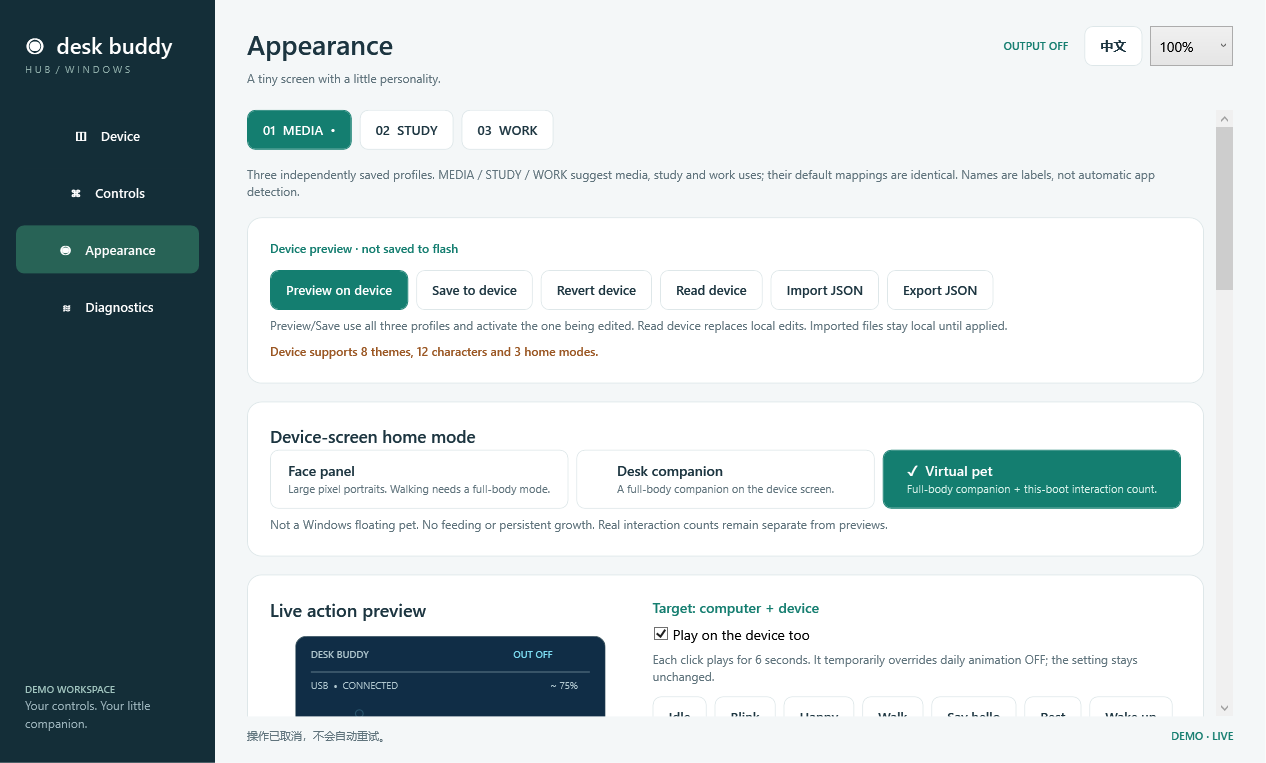
assets/hub-appearance.png
