Carlos-0798/desk-buddy/assets/hub-controls.png

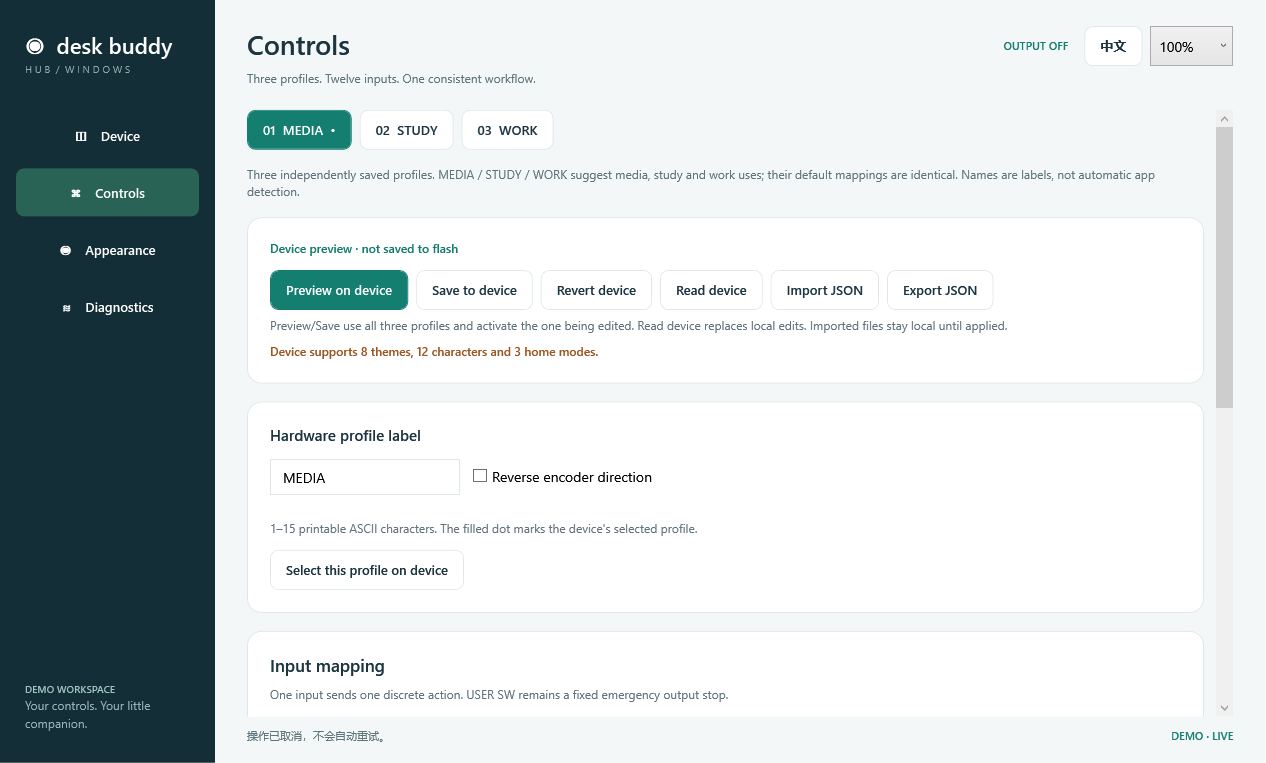
assets/hub-controls.png
