Carlos-0798/desk-buddy/cad/stl/12_tft_spacer_3mm.stl

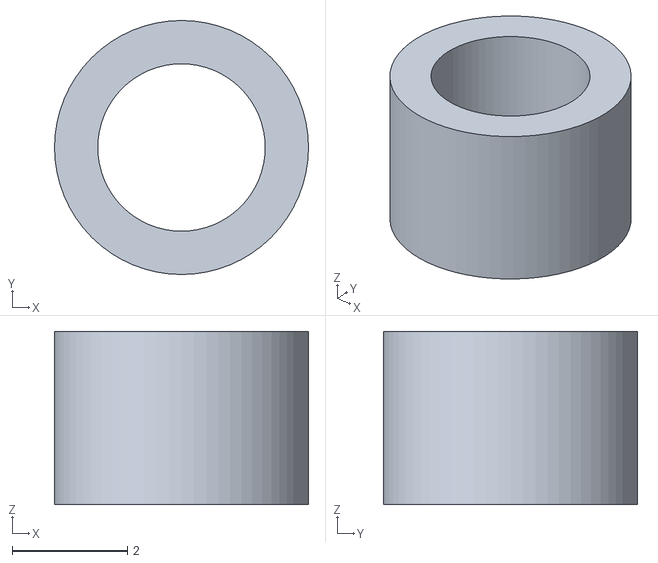
[picture p20: CAD file, 2026-10-09]
cad/stl/12_tft_spacer_3mm.stl
4.40 x 4.40 x 3.00
