Carlos-0798/desk-buddy/cad/stl/10_base.stl

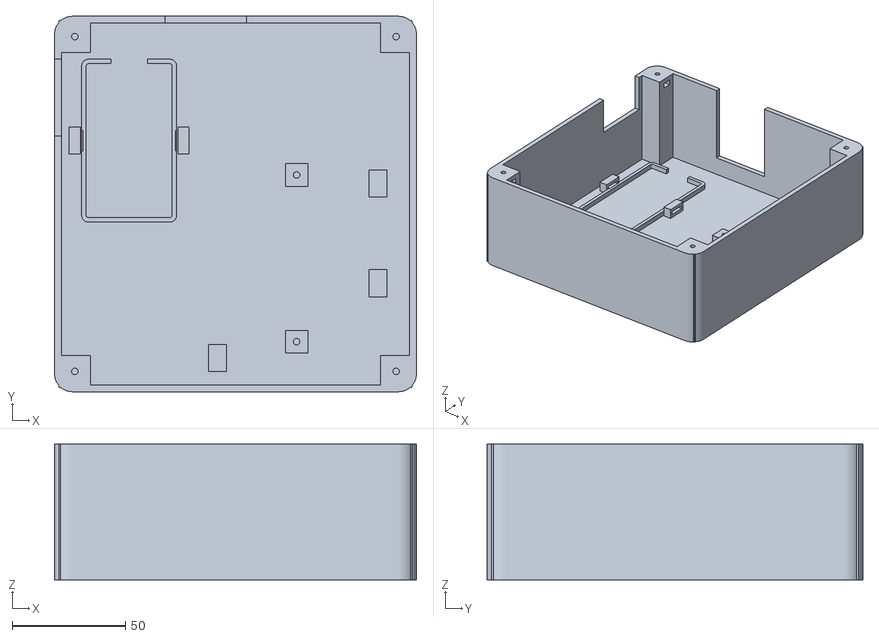
[picture p21: CAD file, 2026-10-09]
cad/stl/10_base.stl
160.0 x 166.0 x 60.0
