Carlos-0798/desk-buddy/cad/stl/11_lid.stl

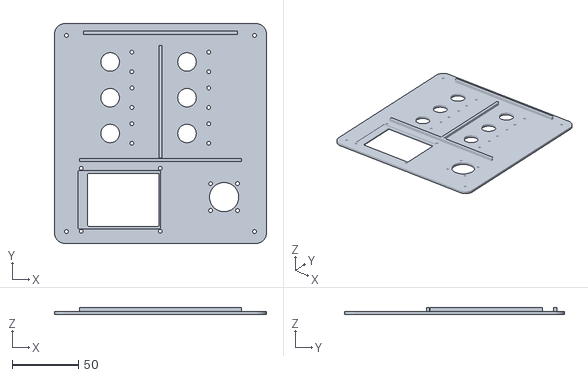
[picture p22: CAD file, 2026-10-09]
cad/stl/11_lid.stl
160.0 x 166.0 x 5.40
