Carlos-0798/desk-buddy/cad/reference-r4/solder-42-points.csv

joint | board | hole | net | world_x | world_y | world_z | operation
F-RST | 4062 | RST | RST | -6.996 | 26.95 | 58.039 | 独立主板，元件面焊；焊完检查后才插TFT
F-3V | 4062 | 3V | 3V | -6.996 | 26.95 | 55.499 | 独立主板，元件面焊；焊完检查后才插TFT
F-AREF | 4062 | AREF | AREF | -6.996 | 26.95 | 52.959 | 独立主板，元件面焊；焊完检查后才插TFT
F-GND | 4062 | GND | GND | -6.996 | 26.95 | 50.419 | 独立主板，元件面焊；焊完检查后才插TFT
F-A0 | 4062 | A0 | A0 | -6.996 | 26.95 | 47.879 | 独立主板，元件面焊；焊完检查后才插TFT
F-A1 | 4062 | A1 | A1 | -6.996 | 26.95 | 45.339 | 独立主板，元件面焊；焊完检查后才插TFT
F-A2 | 4062 | A2 | A2 | -6.996 | 26.95 | 42.799 | 独立主板，元件面焊；焊完检查后才插TFT
F-A3 | 4062 | A3 | A3 | -6.996 | 26.95 | 40.259 | 独立主板，元件面焊；焊完检查后才插TFT
F-A4 | 4062 | A4 | A4 | -6.996 | 26.95 | 37.719 | 独立主板，元件面焊；焊完检查后才插TFT
F-A5 | 4062 | A5 | A5 | -6.996 | 26.95 | 35.179 | 独立主板，元件面焊；焊完检查后才插TFT
F-SCK | 4062 | SCK | SCK | -6.996 | 26.95 | 32.639 | 独立主板，元件面焊；焊完检查后才插TFT
F-MOSI | 4062 | MOSI | MOSI | -6.996 | 26.95 | 30.099 | 独立主板，元件面焊；焊完检查后才插TFT
F-MISO | 4062 | MISO | MISO | -6.996 | 26.95 | 27.559 | 独立主板，元件面焊；焊完检查后才插TFT
F-RX | 4062 | RX | RX | -6.996 | 26.95 | 25.019 | 独立主板，元件面焊；焊完检查后才插TFT
F-TX | 4062 | TX | TX | -6.996 | 26.95 | 22.479 | 独立主板，元件面焊；焊完检查后才插TFT
F-D2 | 4062 | D2 | D2 | -6.996 | 26.95 | 19.939 | 独立主板，元件面焊；焊完检查后才插TFT
F-BAT | 4062 | BAT | BAT | 13.324 | 26.95 | 47.879 | 独立主板，元件面焊；焊完检查后才插TFT
F-EN | 4062 | EN | EN | 13.324 | 26.95 | 45.339 | 独立主板，元件面焊；焊完检查后才插TFT
F-USB | 4062 | USB | USB | 13.324 | 26.95 | 42.799 | 独立主板，元件面焊；焊完检查后才插TFT
F-D13 | 4062 | D13 | D13 | 13.324 | 26.95 | 40.259 | 独立主板，元件面焊；焊完检查后才插TFT
F-D12 | 4062 | D12 | D12 | 13.324 | 26.95 | 37.719 | 独立主板，元件面焊；焊完检查后才插TFT
F-D11 | 4062 | D11 | D11 | 13.324 | 26.95 | 35.179 | 独立主板，元件面焊；焊完检查后才插TFT
F-D10 | 4062 | D10 | D10 | 13.324 | 26.95 | 32.639 | 独立主板，元件面焊；焊完检查后才插TFT
F-D9 | 4062 | D9 | D9 | 13.324 | 26.95 | 30.099 | 独立主板，元件面焊；焊完检查后才插TFT
F-D6 | 4062 | D6 | D6 | 13.324 | 26.95 | 27.559 | 独立主板，元件面焊；焊完检查后才插TFT
F-D5 | 4062 | D5 | D5 | 13.324 | 26.95 | 25.019 | 独立主板，元件面焊；焊完检查后才插TFT
F-SCL | 4062 | SCL | SCL | 13.324 | 26.95 | 22.479 | 独立主板，元件面焊；焊完检查后才插TFT
F-SDA | 4062 | SDA | SDA | 13.324 | 26.95 | 19.939 | 独立主板，元件面焊；焊完检查后才插TFT
FEED-3V | 571 | FJ+3 | 3V | 42.95 | 6.38 | 19.85 | 独立Perma，白色面进线，铜面焊接；检查14点后装底层
FEED-GND | 571 | FJ-3 | GND | 45.49 | 6.38 | 19.85 | 独立Perma，白色面进线，铜面焊接；检查14点后装底层
K1-3V | 571 | FJ+11 | 3V | 42.95 | 6.38 | -0.47 | 独立Perma，白色面进线，铜面焊接；检查14点后装底层
K1-GND | 571 | FJ-11 | GND | 45.49 | 6.38 | -0.47 | 独立Perma，白色面进线，铜面焊接；检查14点后装底层
K2-3V | 571 | FJ+14 | 3V | 42.95 | 6.38 | -8.09 | 独立Perma，白色面进线，铜面焊接；检查14点后装底层
K2-GND | 571 | FJ-14 | GND | 45.49 | 6.38 | -8.09 | 独立Perma，白色面进线，铜面焊接；检查14点后装底层
K3-3V | 571 | FJ+21 | 3V | 42.95 | 6.38 | -25.87 | 独立Perma，白色面进线，铜面焊接；检查14点后装底层
K3-GND | 571 | FJ-21 | GND | 45.49 | 6.38 | -25.87 | 独立Perma，白色面进线，铜面焊接；检查14点后装底层
K4-3V | 571 | FJ+24 | 3V | 42.95 | 6.38 | -33.49 | 独立Perma，白色面进线，铜面焊接；检查14点后装底层
K4-GND | 571 | FJ-24 | GND | 45.49 | 6.38 | -33.49 | 独立Perma，白色面进线，铜面焊接；检查14点后装底层
K5-3V | 571 | FJ+27 | 3V | 42.95 | 6.38 | -41.11 | 独立Perma，白色面进线，铜面焊接；检查14点后装底层
K5-GND | 571 | FJ-27 | GND | 45.49 | 6.38 | -41.11 | 独立Perma，白色面进线，铜面焊接；检查14点后装底层
K6-3V | 571 | FJ+30 | 3V | 42.95 | 6.38 | -48.73 | 独立Perma，白色面进线，铜面焊接；检查14点后装底层
K6-GND | 571 | FJ-30 | GND | 45.49 | 6.38 | -48.73 | 独立Perma，白色面进线，铜面焊接；检查14点后装底层
