Carlos-0798/desk-buddy/assets/assembly-2026-10-08/02-upper-internals-before-usb-reroute.jpg

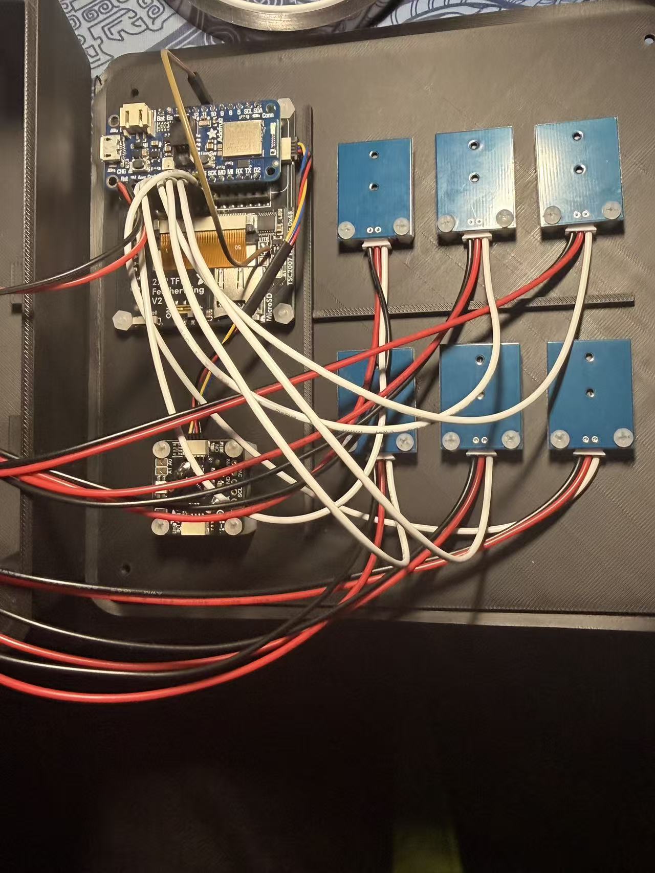
assets/assembly-2026-10-08/02-upper-internals-before-usb-reroute.jpg
