Carlos-0798/desk-buddy/assets/assembly-2026-10-08/03-lower-battery-perma.jpg

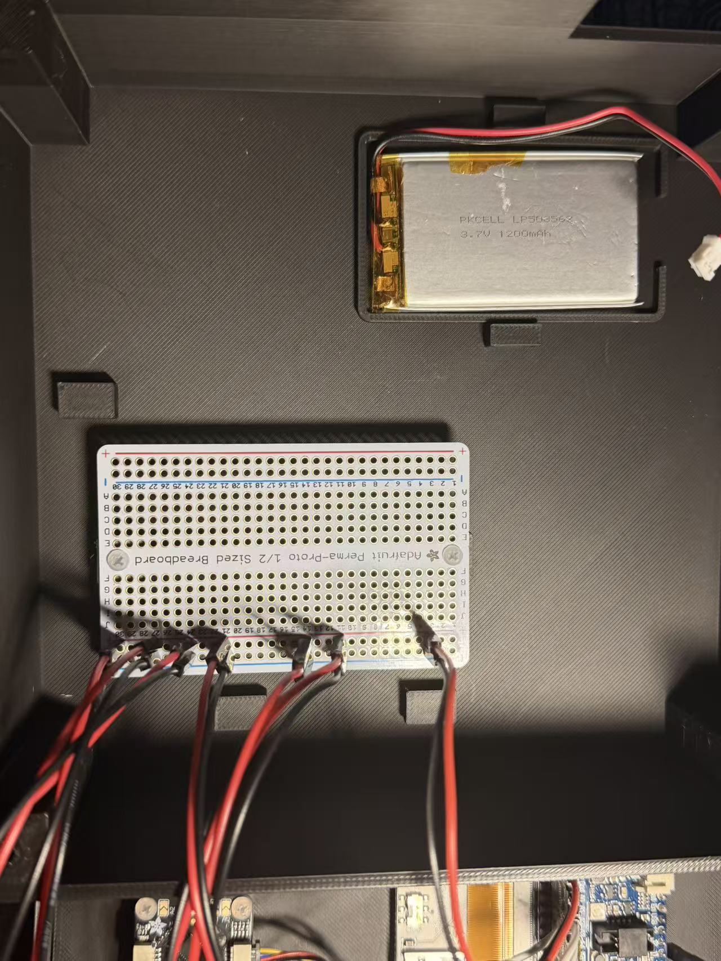
assets/assembly-2026-10-08/03-lower-battery-perma.jpg
