Carlos-0798/desk-buddy/assets/assembly-2026-10-08/04-upper-internals-detail-before-usb-reroute.jpg

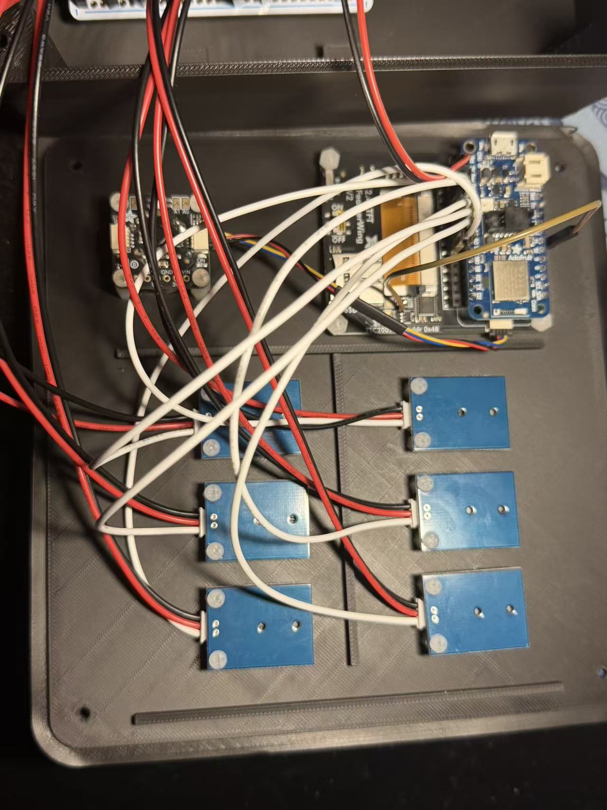
assets/assembly-2026-10-08/04-upper-internals-detail-before-usb-reroute.jpg
