Carlos-0798/desk-buddy/assets/prototype-en-usb.jpg

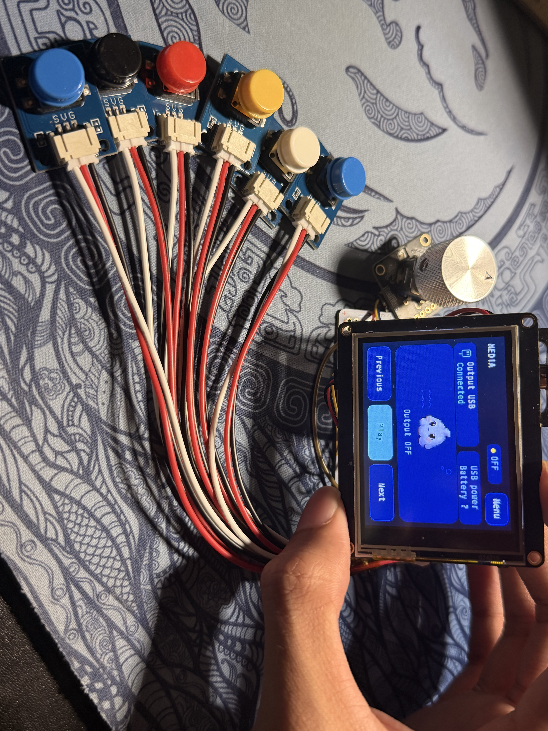
assets/prototype-en-usb.jpg
