Carlos-0798/desk-buddy/assets/prototype-zh-ble-battery.jpg

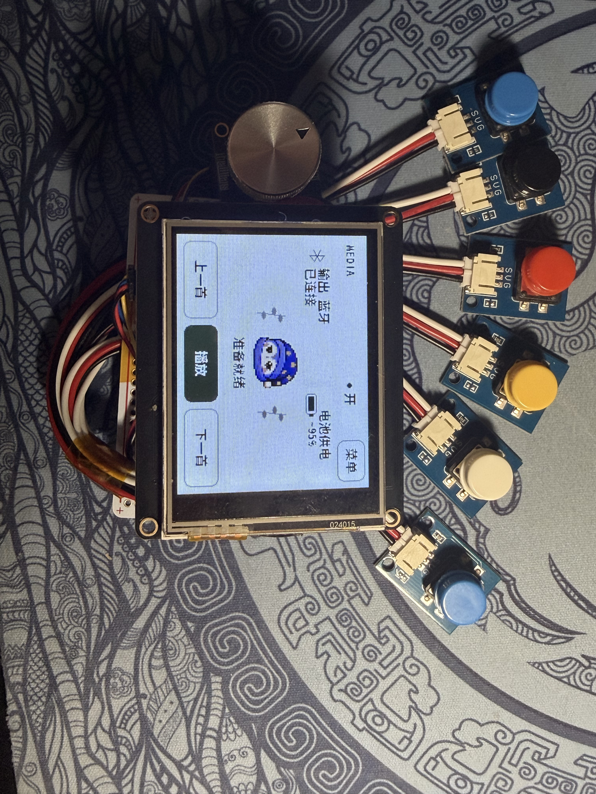
assets/prototype-zh-ble-battery.jpg
