Carlos-0798/desk-buddy/assets/prototype-back-wiring.jpg

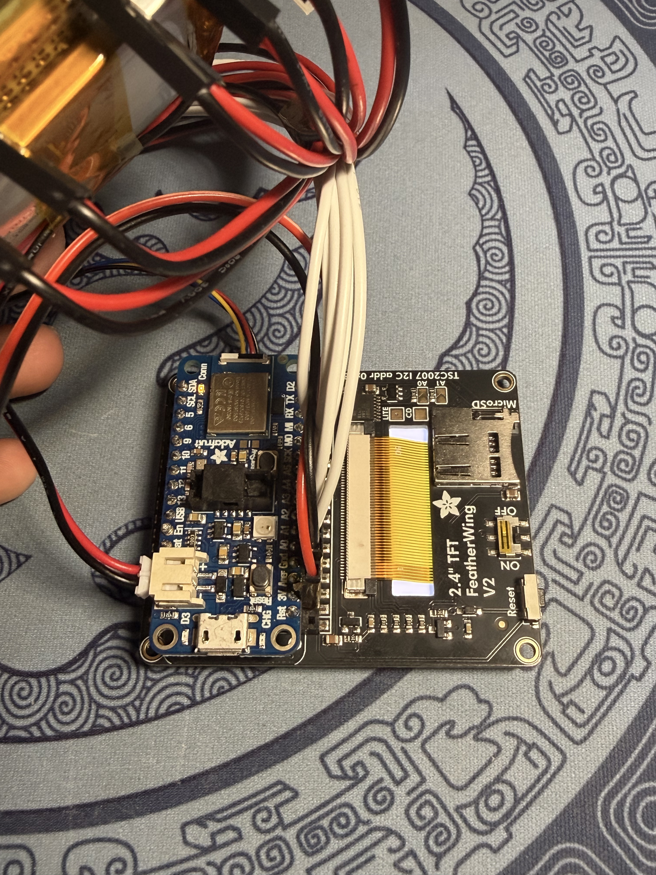
assets/prototype-back-wiring.jpg
